covie154/smartknob/PCB_Scroller/Scroller1 two/Scroller1 two.pdf

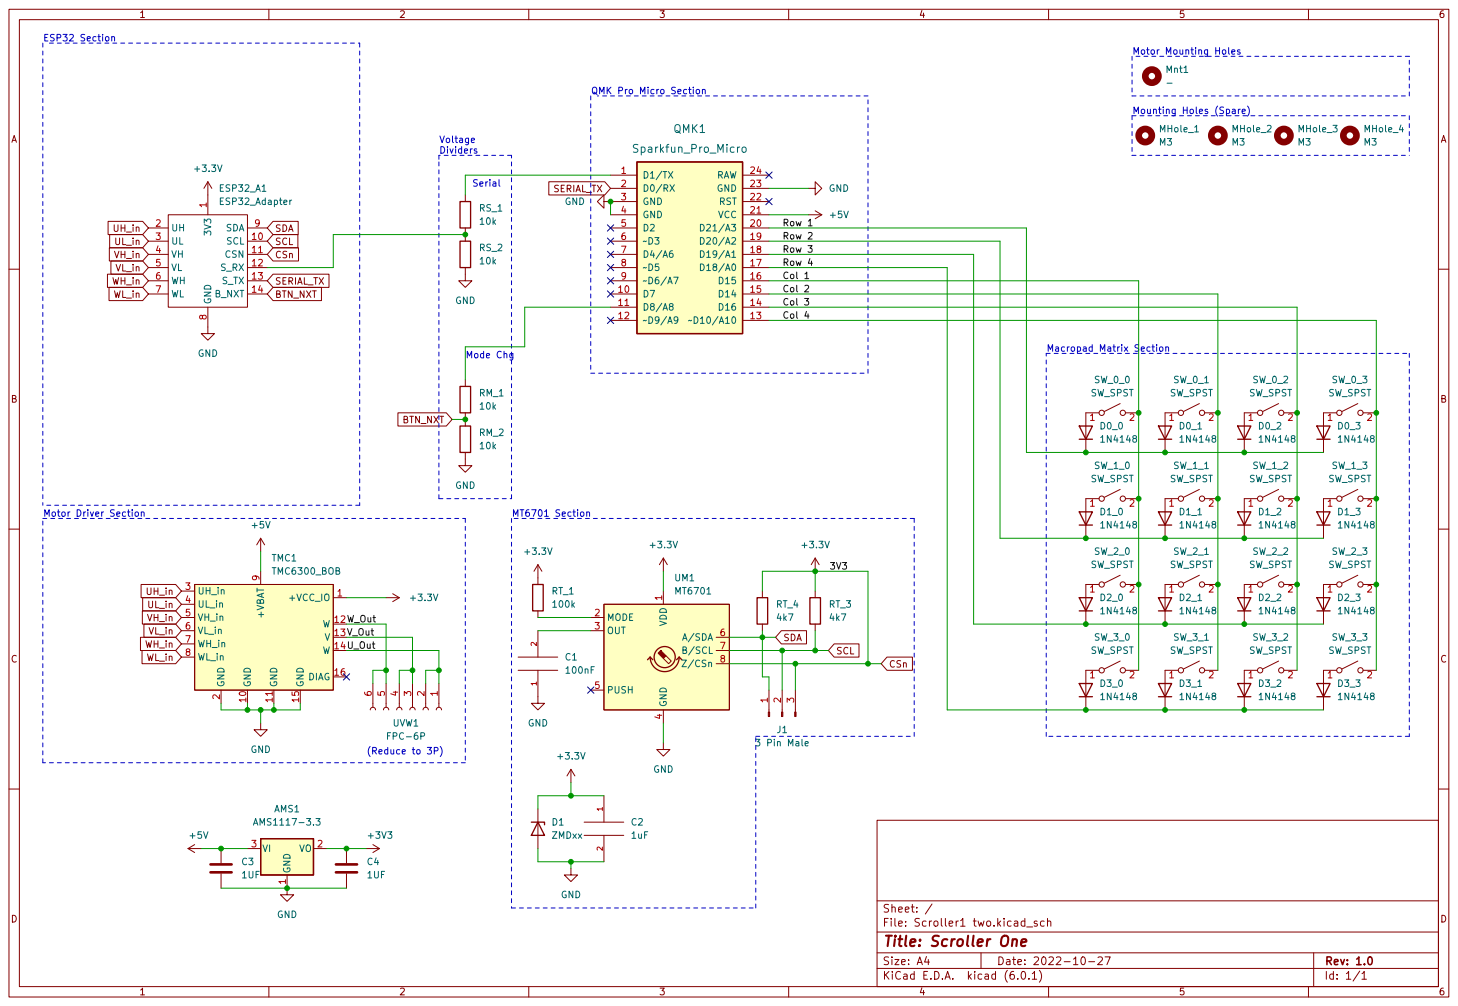
[picture p2: page 1]

Voltage Dividers Motor Driver Section

1 SCL 10 CSN 11 S_RX 12 S_TX 13 B_NXT 14 UH 2 UL 3 VH 4 VL 5 WH 6 WL 7 GND

1 2 SW_0_0 SW_SPST | 1 2 SW_0_1 SW_SPST D0_0 | 1 D0_2 2 SW_0_2 SW_SPST

1 2 SW_1_0 SW_SPST | 1 2 SW_1_1 SW_SPST 1 2 SW_2_1 SW_SPST D1_1

4 PUSH 5 A/SDA 6 B/SCL 7 Z/CSn 8 UM1 MT6701

Id: 1/1 Title: Scroller One
