covie154/smartknob/PCB_Scroller/Scroller1/Scroller1.pdf

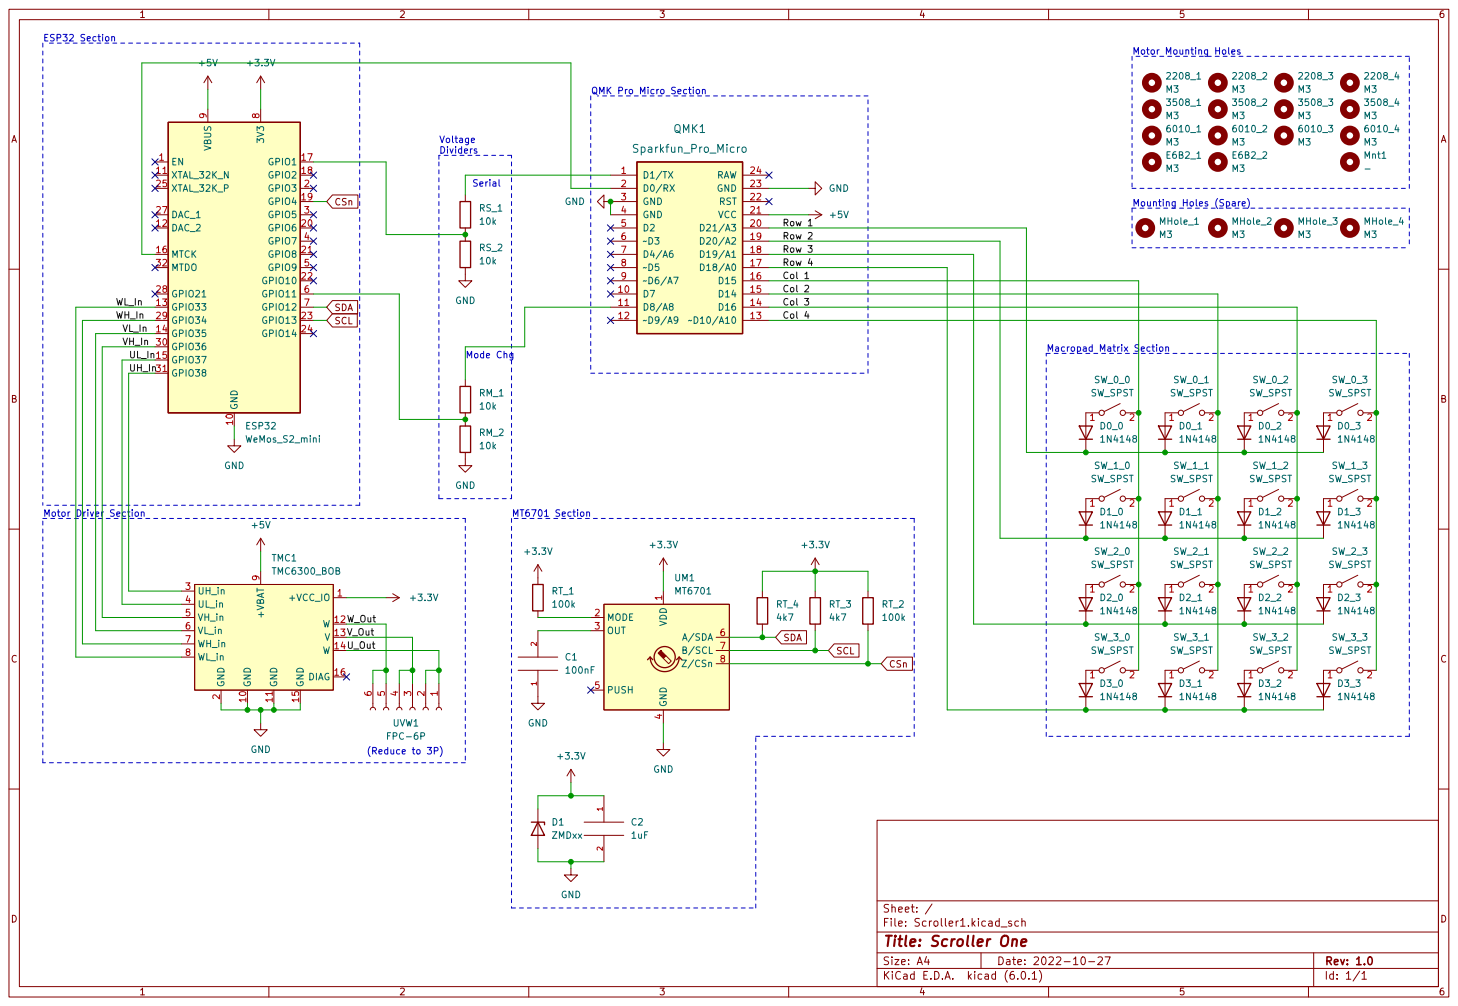
[picture p3: page 1]

Macropad Matrix Section Motor Driver Section

1 2 SW_1_1 SW_SPST 1 2 SW_2_1 SW_SPST D1_1 | 1 2 SW_1_2 SW_SPST

4 PUSH 5 A/SDA 6 B/SCL 7 Z/CSn 8 UM1 MT6701 GND

1 2 SW_2_0 SW_SPST

File: Scroller1.kicad_sch Sheet: /
Id: 1/1 Title: Scroller One
