covie154/smartknob/PCB_Scroller/ESP32_Adapter/ESP32_Adapter.kicad_pcb

## KiCad design PCB_Scroller/ESP32_Adapter/ESP32_Adapter.kicad_pcb (2023-05-04)

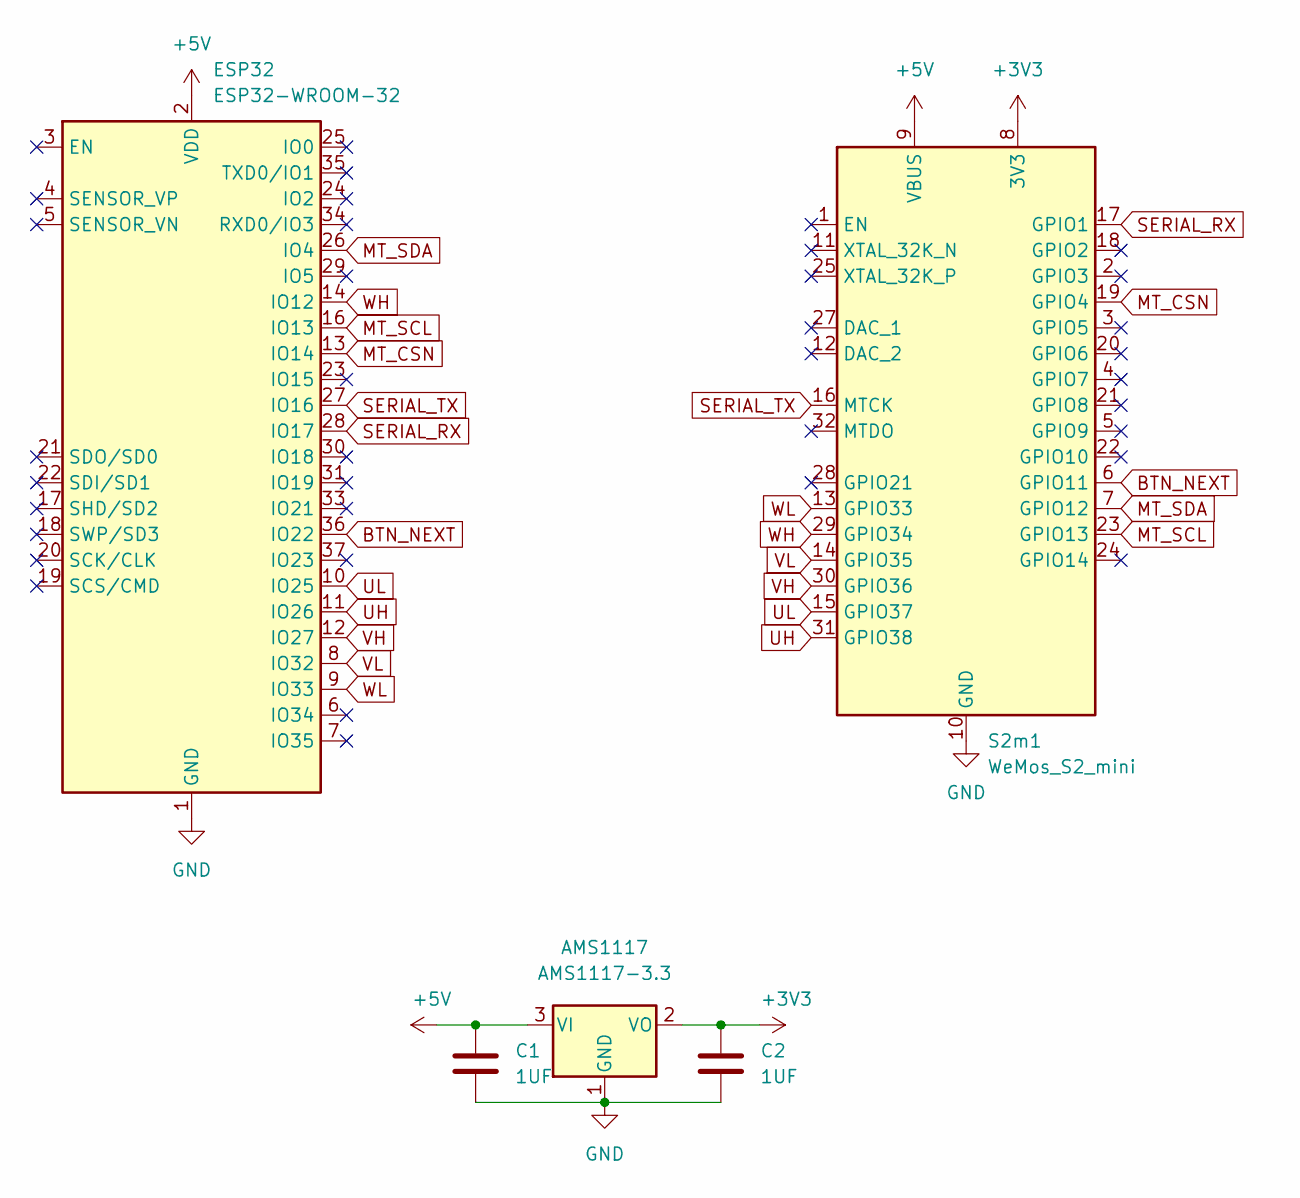
[picture p4: schematic ESP32_Adapter.kicad_sch]

Parts:
AMS1117: AMS1117-3.3; SOT-223-3_TabPin2
C1, C2: 1UF; C_0603_1608Metric_Pad1.08x0.95mm_HandSolder
ESP32: ESP32-WROOM-32
S2m1: WeMos_S2_mini; WEMOS_S2_mini

Connections:
+3V3: AMS1117.2 (VO), C2.1, S2m1.8 (3V3)
+5V: AMS1117.3 (VI), C1.1, ESP32.2 (VDD), S2m1.9 (VBUS)
BTN_NEXT: ESP32.36 (IO22), S2m1.6 (GPIO11)
GND: AMS1117.1 (GND), C1.2, C2.2, ESP32.1 (GND), ESP32.15 (GND), ESP32.38 (GND), ESP32.39 (GND), S2m1.10 (GND), S2m1.26 (GND)
MT_CSN: ESP32.13 (IO14), S2m1.19 (GPIO4)
MT_SCL: ESP32.16 (IO13), S2m1.23 (GPIO13)
MT_SDA: ESP32.26 (IO4), S2m1.7 (GPIO12)
SERIAL_RX: ESP32.28 (IO17), S2m1.17 (GPIO1)
SERIAL_TX: ESP32.27 (IO16), S2m1.16 (MTCK)
UH: ESP32.11 (IO26), S2m1.31 (GPIO38)
UL: ESP32.10 (IO25), S2m1.15 (GPIO37)
VH: ESP32.12 (IO27), S2m1.30 (GPIO36)
VL: ESP32.8 (IO32), S2m1.14 (GPIO35)
WH: ESP32.14 (IO12), S2m1.29 (GPIO34)
WL: ESP32.9 (IO33), S2m1.13 (GPIO33)

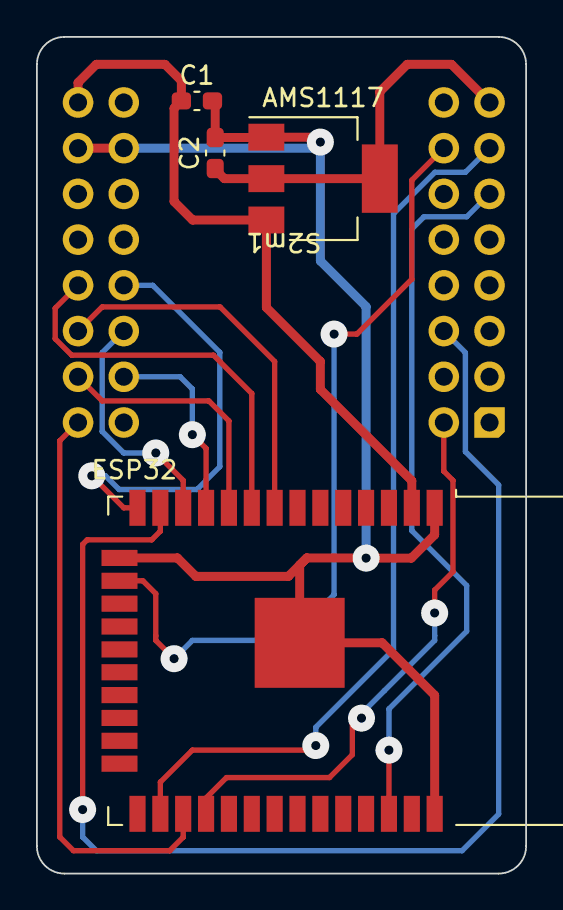
[picture p5: board ESP32_Adapter.kicad_pcb from above]

Board: 2 copper layers, 27.2 x 46.5 mm, 5 parts (0 on the bottom side), 15 nets.
