covie154/smartknob/PCB_Scroller/Scroller Motor 1/Scroller Motor 1.kicad_pcb

## KiCad design PCB_Scroller/Scroller Motor 1/Scroller Motor 1.kicad_pcb (2023-05-04)

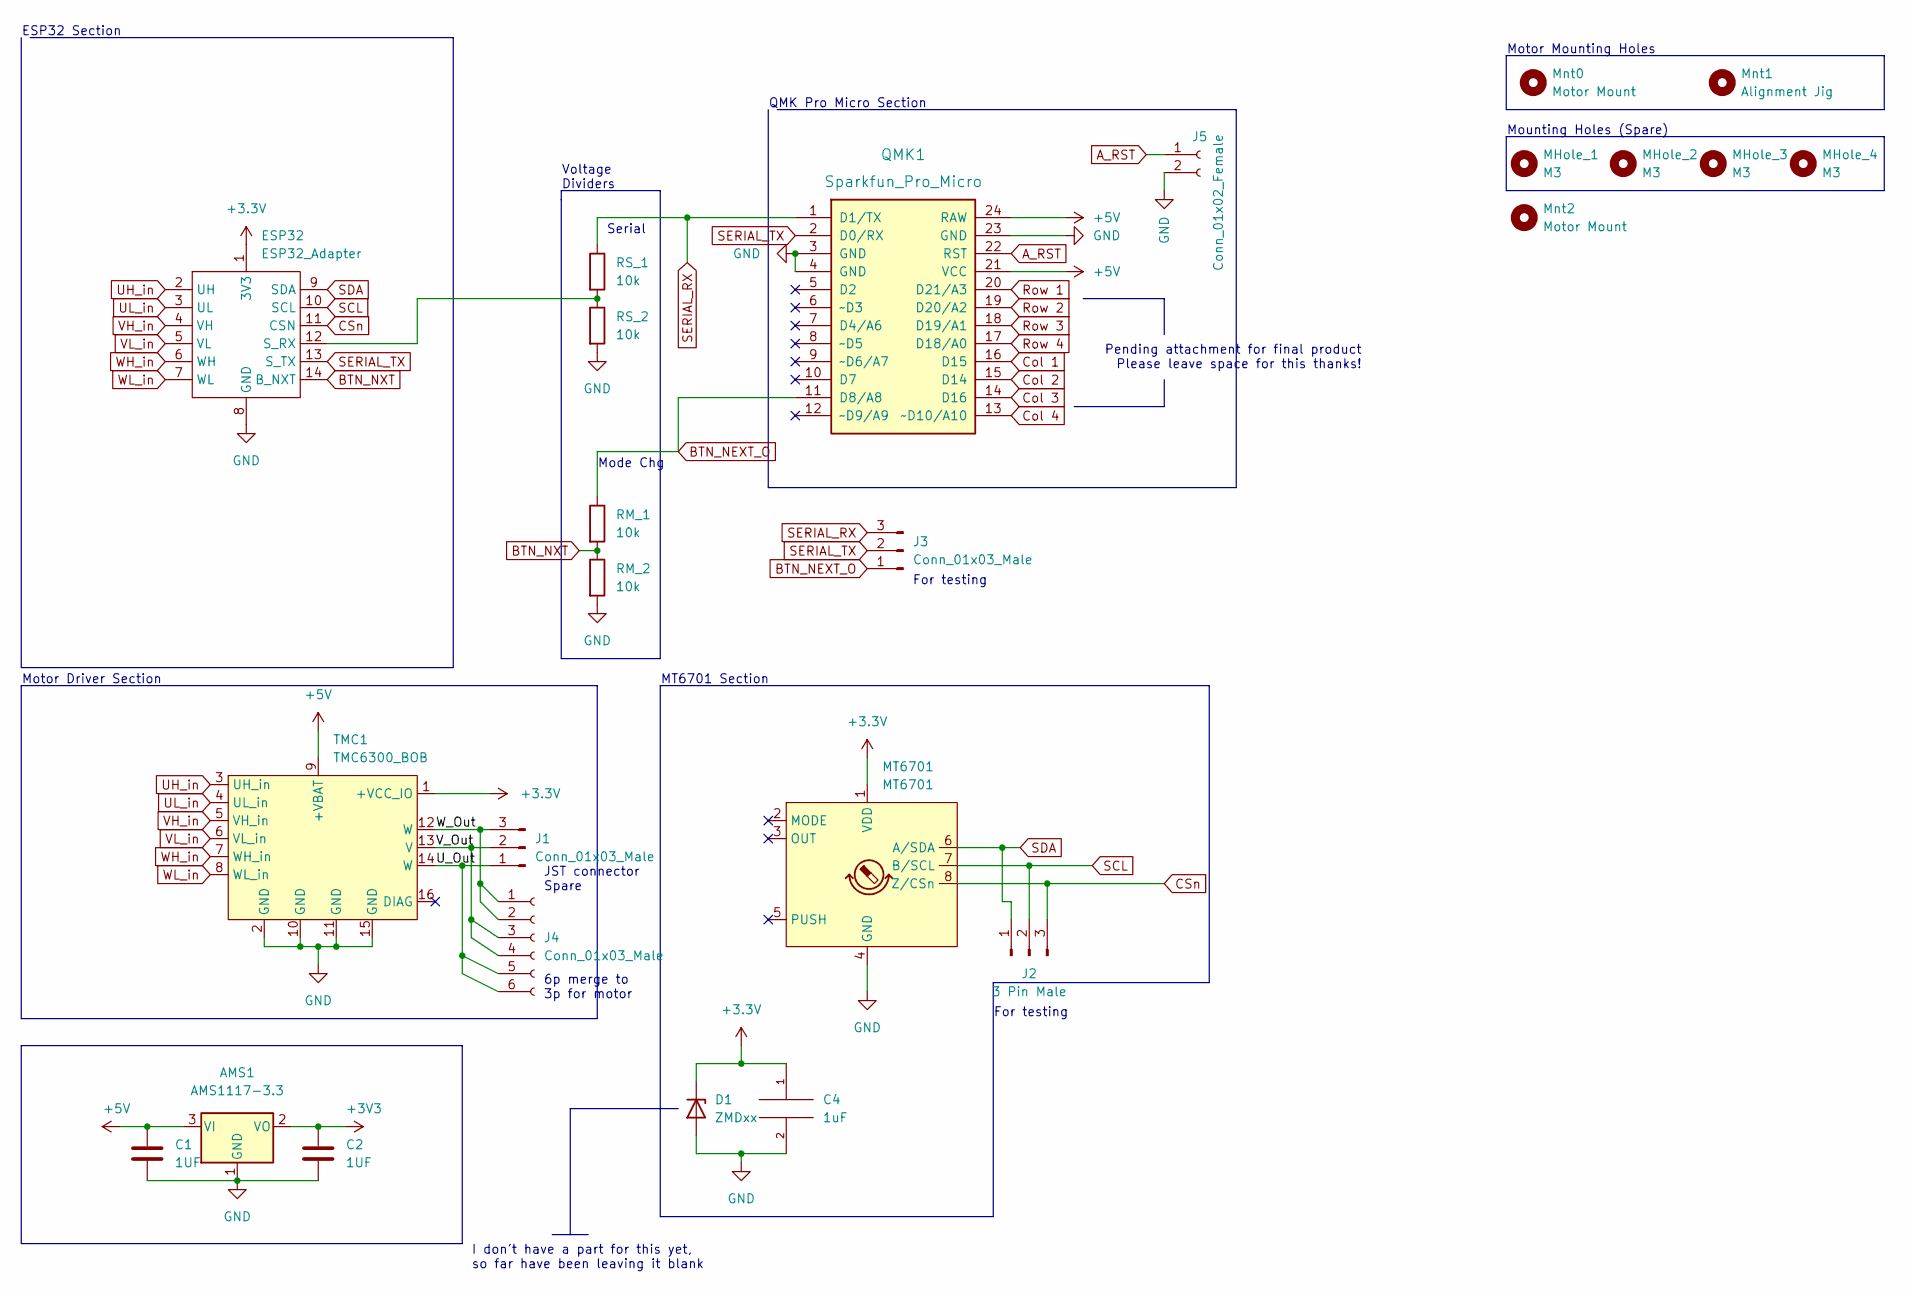
[picture p6: schematic Scroller Motor 1.kicad_sch]

Parts:
AMS1: AMS1117-3.3; SOT-223-3_TabPin2
C1, C2: 1UF; C_0603_1608Metric_Pad1.08x0.95mm_HandSolder
C4: 1uF; C_0603_1608Metric_Pad1.08x0.95mm_HandSolder
D1: ZMDxx; D_SOD-123
ESP32: ESP32_Adapter; ESP32 Motor Adapter
J1: Conn_01x03_Male; JST_XH_B3B-XH-AM_1x03_P2.50mm_Vertical
J2: 3 Pin Male; PinHeader_1x03_P2.54mm_Vertical
J3: Conn_01x03_Male; PinHeader_1x03_P2.54mm_Vertical
J4: Conn_01x03_Male; Hirose_FH12-6S-0.5SH_1x06-1MP_P0.50mm_Horizontal
J5: Conn_01x02_Female; PinHeader_1x02_P2.54mm_Vertical
MHole_1, MHole_2, MHole_3, MHole_4: M3; MountingHole_3.2mm_M3
MT6701: MT6701; SOIC-8
Mnt0: Motor Mount; BLDC Mount 3
Mnt1: Alignment Jig; Jig Mnt
Mnt2: Motor Mount; BLDC 3514
QMK1: Sparkfun_Pro_Micro
RM_1, RM_2: 10k; R_0603_1608Metric_Pad0.98x0.95mm_HandSolder
RS_1, RS_2: 10k; R_0603_1608Metric_Pad0.98x0.95mm_HandSolder
TMC1: TMC6300_BOB

Connections:
+5V: AMS1.3 (VI), C1.1, QMK1.21 (VCC), QMK1.24 (RAW), TMC1.9 (+VBAT)
/U_Out: J1.1, J4.5, J4.6, TMC1.14 (W)
/V_Out: J1.2, J4.3, J4.4, TMC1.13 (V)
/W_Out: J1.3, J4.1, J4.2, TMC1.12 (W)
A_RST: J5.1, QMK1.22 (RST)
BTN_NEXT_O: J3.1, QMK1.11 (D8/A8), RM_1.1
BTN_NXT: ESP32.14 (B_NXT), RM_1.2, RM_2.1
CSn: ESP32.11 (CSN), J2.3, MT6701.8 (Z/CSn)
Col 1: QMK1.16 (D15)
Col 2: QMK1.15 (D14)
Col 3: QMK1.14 (D16)
Col 4: QMK1.13 (~D10/A10)
GND: AMS1.1 (GND), C1.2, C2.2, C4.2, D1.2 (A), ESP32.8 (GND), J5.2, MT6701.4 (GND), QMK1.3 (GND), QMK1.4 (GND), QMK1.23 (GND), RM_2.2, RS_2.2, TMC1.2 (GND), TMC1.10 (GND), TMC1.11 (GND), TMC1.15 (GND)
unnamed: ESP32.12 (S_RX), RS_1.2, RS_2.1
Row 1: QMK1.20 (D21/A3)
Row 2: QMK1.19 (D20/A2)
Row 3: QMK1.18 (D19/A1)
Row 4: QMK1.17 (D18/A0)
SCL: ESP32.10 (SCL), J2.2, MT6701.7 (B/SCL)
SDA: ESP32.9 (SDA), J2.1, MT6701.6 (A/SDA)
SERIAL_RX: J3.3, QMK1.1 (D1/TX), RS_1.1
SERIAL_TX: ESP32.13 (S_TX), J3.2, QMK1.2 (D0/RX)
UH_in: ESP32.2 (UH), TMC1.3 (UH_in)
UL_in: ESP32.3 (UL), TMC1.4 (UL_in)
VH_in: ESP32.4 (VH), TMC1.5 (VH_in)
VL_in: ESP32.5 (VL), TMC1.6 (VL_in)
WH_in: ESP32.6 (WH), TMC1.7 (WH_in)
WL_in: ESP32.7 (WL), TMC1.8 (WL_in)

Notes on the sheet:
Mode Chg
For testing
Pending attachment for final product Please leave space for this thanks!
6p merge to 3p for motor
JST connector Spare
Motor Mounting Holes
Serial
ESP32 Section
Mounting Holes (Spare)
Voltage Dividers
MT6701 Section
I don't have a part for this yet, so far have been leaving it blank
QMK Pro Micro Section
Motor Driver Section

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
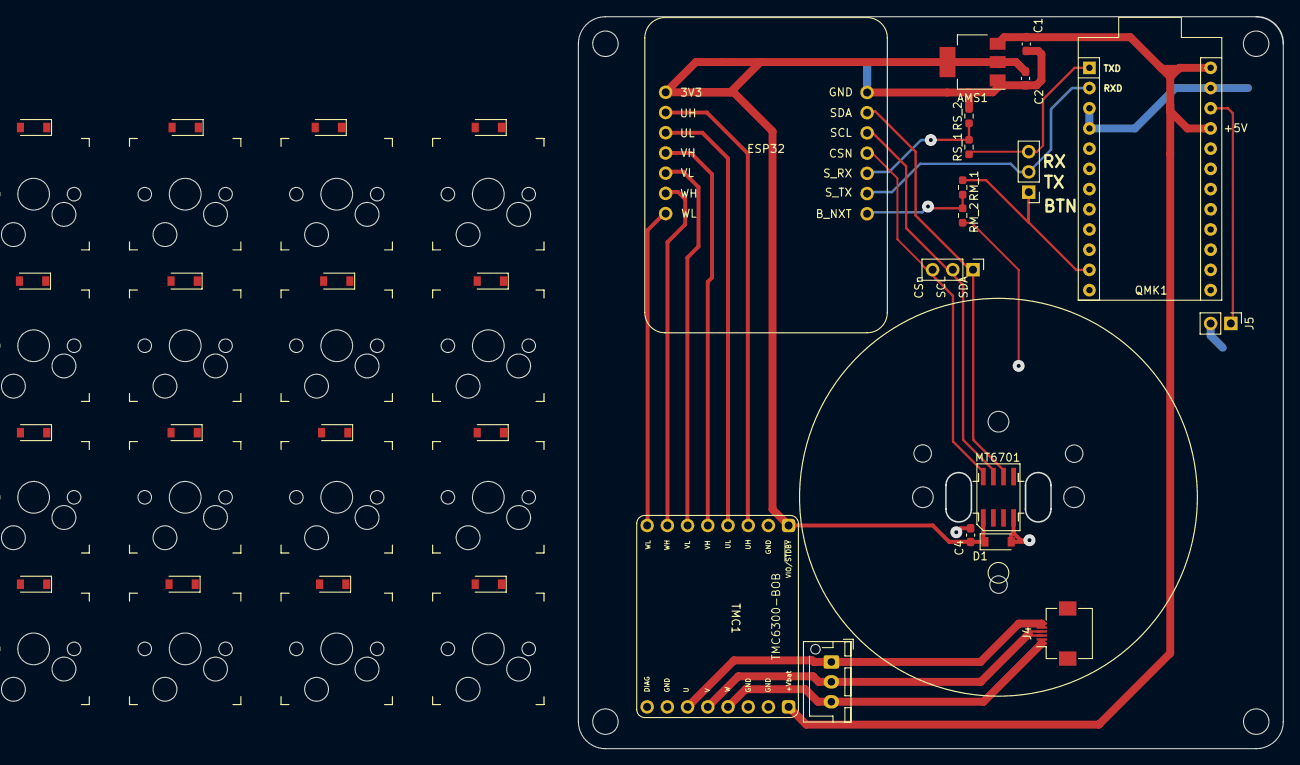
[picture p7: board Scroller Motor 1.kicad_pcb from above]

Board: 2 copper layers, 88.6 x 92.0 mm, 25 parts (0 on the bottom side), 21 nets.
