covie154/smartknob/PCB_Scroller/ESP32_Adapter 2/ESP32_Adapter 2.kicad_pcb

## KiCad design PCB_Scroller/ESP32_Adapter 2/ESP32_Adapter 2.kicad_pcb (2023-05-04)

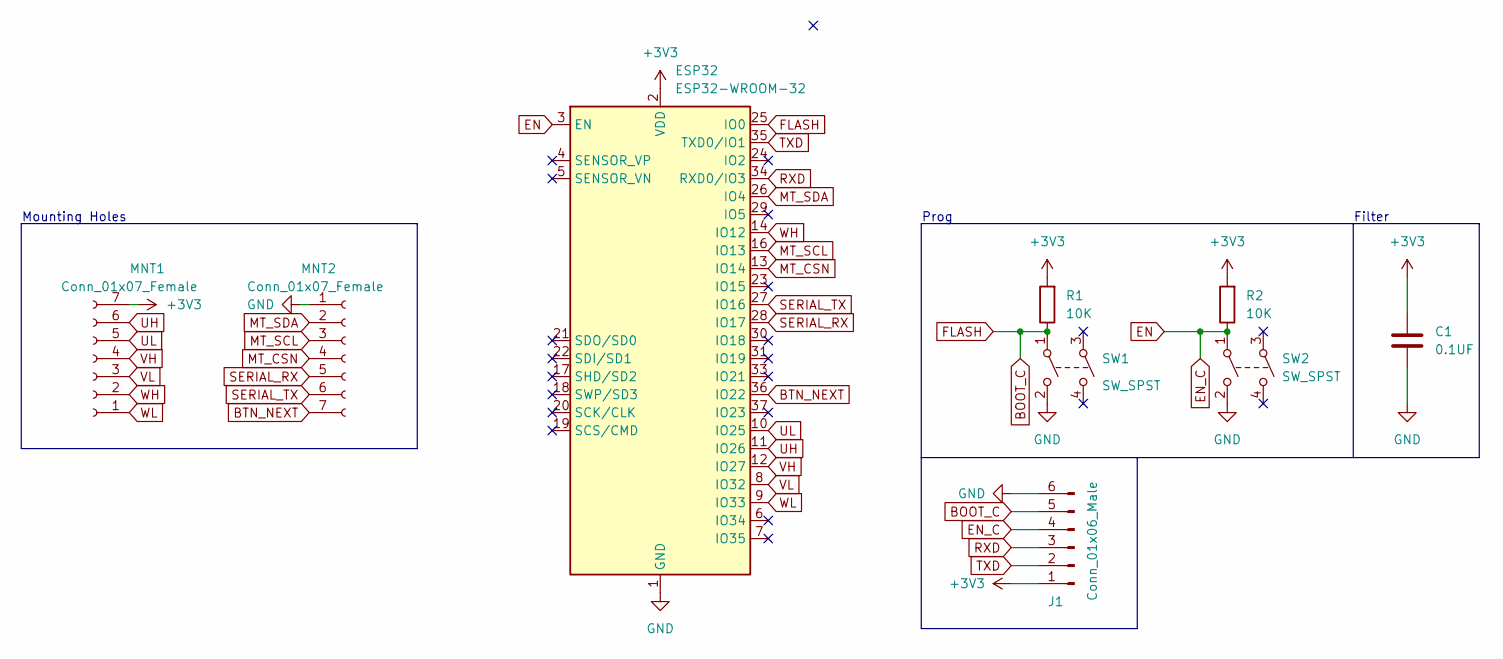
[picture p8: schematic ESP32_Adapter 2.kicad_sch]

Parts:
C1: 0.1UF; C_0603_1608Metric_Pad1.08x0.95mm_HandSolder
ESP32: ESP32-WROOM-32
J1: Conn_01x06_Male; PinHeader_1x07_P2.54mm_Horizontal
MNT1, MNT2: Conn_01x07_Female; PinSocket_1x07_P2.54mm_Vertical
R1, R2: 10K; R_0603_1608Metric_Pad0.98x0.95mm_HandSolder
SW1, SW2: SW_SPST; PTS525SM08SMTR2LFS

Connections:
+3V3: C1.1, ESP32.2 (VDD), J1.1, MNT1.7, R1.2, R2.2
BTN_NEXT: ESP32.36 (IO22), MNT2.7
EN: ESP32.3 (EN), J1.4, R2.1, SW2.1
FLASH: ESP32.25 (IO0), J1.5, R1.1, SW1.1
GND: C1.2, ESP32.1 (GND), ESP32.15 (GND), ESP32.38 (GND), ESP32.39 (GND), J1.6, MNT2.1, SW1.2, SW2.2
MT_CSN: ESP32.13 (IO14), MNT2.4
MT_SCL: ESP32.16 (IO13), MNT2.3
MT_SDA: ESP32.26 (IO4), MNT2.2
RXD: ESP32.34 (RXD0/IO3), J1.3
SERIAL_RX: ESP32.28 (IO17), MNT2.5
SERIAL_TX: ESP32.27 (IO16), MNT2.6
TXD: ESP32.35 (TXD0/IO1), J1.2
UH: ESP32.11 (IO26), MNT1.6
UL: ESP32.10 (IO25), MNT1.5
VH: ESP32.12 (IO27), MNT1.4
VL: ESP32.8 (IO32), MNT1.3
WH: ESP32.14 (IO12), MNT1.2
WL: ESP32.9 (IO33), MNT1.1

Notes on the sheet:
Mounting Holes
Filter
Prog

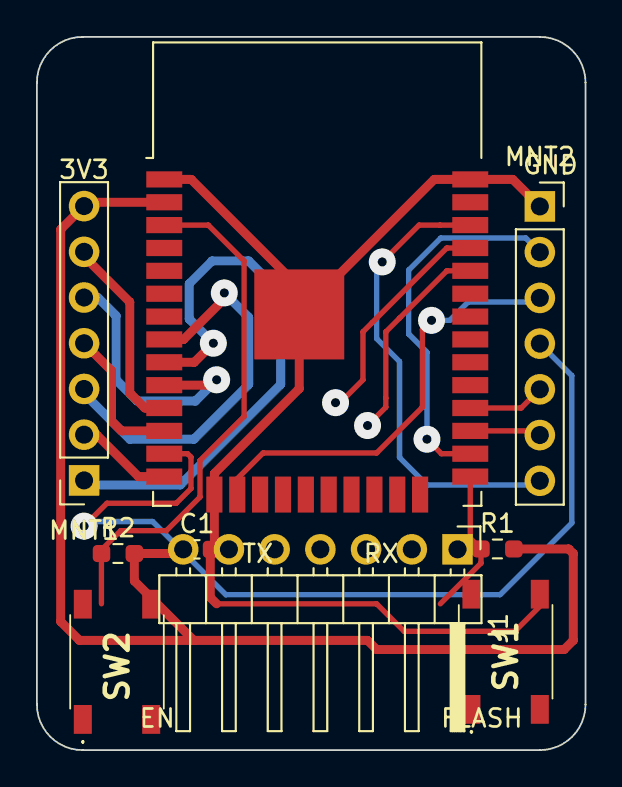
[picture p9: board ESP32_Adapter 2.kicad_pcb from above]

Board: 2 copper layers, 30.5 x 39.6 mm, 9 parts (0 on the bottom side), 18 nets.
