covie154/smartknob/PCB_Scroller/Scroller1 two/Scroller1 two.kicad_pcb

## KiCad design PCB_Scroller/Scroller1 two/Scroller1 two.kicad_pcb (2023-05-04)

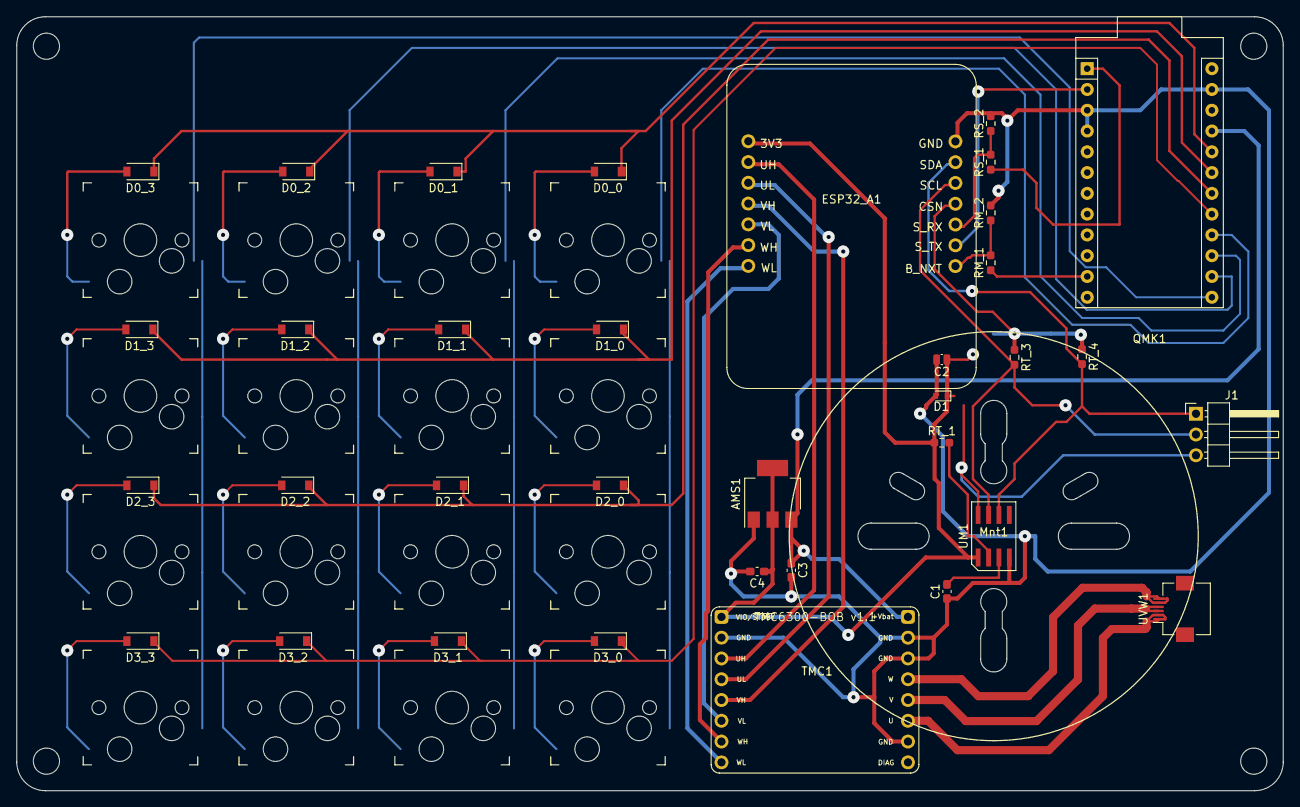
[picture p10: board Scroller1 two.kicad_pcb from above]

Board: 2 copper layers, 154.8 x 94.6 mm, 56 parts (0 on the bottom side), 44 nets.

Parts:
AMS1: AMS1117-3.3; SOT-223-3_TabPin2
C1: 100nF; C_0603_1608Metric_Pad1.08x0.95mm_HandSolder
C2: 1uF; C_0504_1310Metric_Pad0.83x1.28mm_HandSolder
C3, C4: 1UF; C_0603_1608Metric_Pad1.08x0.95mm_HandSolder
D0_0, D0_1, D0_2, D0_3, D1_0, D1_1, D1_2, D1_3, D2_0, D2_1, D2_2, D2_3, D3_0, D3_1, D3_2, D3_3: 1N4148; D_SOD-123
D1: ZMDxx; D_SOD-523
ESP32_A1: ESP32_Adapter; ESP32 Motor Adapter
J1: 3 Pin Male; PinHeader_1x03_P2.54mm_Horizontal
MHole_1, MHole_3, MHole_4, MHole_6: M3; MountingHole_3.2mm_M3
Mnt1: -; BLDC Mount
QMK1: Sparkfun_Pro_Micro
RM_1, RM_2: 10k; R_0603_1608Metric_Pad0.98x0.95mm_HandSolder
RS_1, RS_2: 10k; R_0603_1608Metric_Pad0.98x0.95mm_HandSolder
RT_1: 100k; R_0603_1608Metric_Pad0.98x0.95mm_HandSolder
RT_3, RT_4: 4k7; R_0603_1608Metric_Pad0.98x0.95mm_HandSolder
SW_0_0, SW_0_1, SW_0_2, SW_0_3, SW_1_0, SW_1_1, SW_1_2, SW_1_3, SW_2_0, SW_2_1, SW_2_2, SW_2_3, SW_3_0, SW_3_1, SW_3_2, SW_3_3: SW_SPST; Kailh_socket_MX
TMC1: TMC6300_BOB
UM1: MT6701; SOIC-8
UVW1: FPC-6P; Hirose_FH12-6S-0.5SH_1x06-1MP_P0.50mm_Horizontal

Connections:
+5V: AMS1.3 (VI), C3.1, QMK1.21 (VCC), TMC1.9 (+VBAT)
/Col 1: QMK1.16 (D15), SW_0_0.2 (B), SW_1_0.2 (B), SW_2_0.2 (B), SW_3_0.2 (B)
/Col 2: QMK1.15 (D14), SW_0_1.2 (B), SW_1_1.2 (B), SW_2_1.2 (B), SW_3_1.2 (B)
/Col 3: QMK1.14 (D16), SW_0_2.2 (B), SW_1_2.2 (B), SW_2_2.2 (B), SW_3_2.2 (B)
/Col 4: QMK1.13 (~D10/A10), SW_0_3.2 (B), SW_1_3.2 (B), SW_2_3.2 (B), SW_3_3.2 (B)
/Row 1: D0_0.1 (K), D0_1.1 (K), D0_2.1 (K), D0_3.1 (K), QMK1.20 (D21/A3)
/Row 2: D1_0.1 (K), D1_1.1 (K), D1_2.1 (K), D1_3.1 (K), QMK1.19 (D20/A2)
/Row 3: D2_0.1 (K), D2_1.1 (K), D2_2.1 (K), D2_3.1 (K), QMK1.18 (D19/A1)
/Row 4: D3_0.1 (K), D3_1.1 (K), D3_2.1 (K), D3_3.1 (K), QMK1.17 (D18/A0)
/U_Out: TMC1.14 (W), UVW1.1, UVW1.2
/V_Out: TMC1.13 (V), UVW1.3, UVW1.4
/W_Out: TMC1.12 (W), UVW1.5, UVW1.6
BTN_NXT: RM_1.2, RM_2.1
CSn: AMS1.2 (VO), C2.1, C4.1, D1.1 (K), ESP32_A1.1 (3V3), J1.3, RT_1.1, RT_3.1, RT_4.1, TMC1.1 (+VCC_IO), UM1.1 (VDD), UM1.8 (Z/CSn)
GND: AMS1.1 (GND), C1.1, C2.2, C3.2, C4.2, D1.2 (A), QMK1.3 (GND), QMK1.4 (GND), QMK1.23 (GND), RM_2.2, RS_2.2, TMC1.2 (GND), TMC1.10 (GND), TMC1.11 (GND), TMC1.15 (GND), UM1.4 (GND)
unnamed: C1.2, UM1.3 (OUT)
unnamed: D0_0.2 (A), SW_0_0.1 (A)
unnamed: D0_1.2 (A), SW_0_1.1 (A)
unnamed: D0_2.2 (A), SW_0_2.1 (A)
unnamed: D0_3.2 (A), SW_0_3.1 (A)
unnamed: D1_0.2 (A), SW_1_0.1 (A)
unnamed: D1_1.2 (A), SW_1_1.1 (A)
unnamed: D1_2.2 (A), SW_1_2.1 (A)
unnamed: D1_3.2 (A), SW_1_3.1 (A)
unnamed: D2_0.2 (A), SW_2_0.1 (A)
unnamed: D2_1.2 (A), SW_2_1.1 (A)
unnamed: D2_2.2 (A), SW_2_2.1 (A)
unnamed: D2_3.2 (A), SW_2_3.1 (A)
unnamed: D3_0.2 (A), SW_3_0.1 (A)
unnamed: D3_1.2 (A), SW_3_1.1 (A)
unnamed: D3_2.2 (A), SW_3_2.1 (A)
unnamed: D3_3.2 (A), SW_3_3.1 (A)
unnamed: RS_1.2, RS_2.1
unnamed: QMK1.1 (D1/TX), RS_1.1
unnamed: QMK1.11 (D8/A8), RM_1.1
unnamed: RT_1.2, UM1.2 (MODE)
SCL: J1.2, RT_3.2, UM1.7 (B/SCL)
SDA: J1.1, RT_4.2, UM1.6 (A/SDA)
UH_in: ESP32_A1.2 (UH), TMC1.3 (UH_in)
UL_in: ESP32_A1.3 (UL), TMC1.4 (UL_in)
VH_in: ESP32_A1.4 (VH), TMC1.5 (VH_in)
VL_in: ESP32_A1.5 (VL), TMC1.6 (VL_in)
WH_in: ESP32_A1.6 (WH), TMC1.7 (WH_in)
WL_in: ESP32_A1.7 (WL), TMC1.8 (WL_in)
