covie154/smartknob/PCB_Scroller/TMC6300-BOB/TMC6300-BOB Component.kicad_pcb

## KiCad design PCB_Scroller/TMC6300-BOB/TMC6300-BOB Component.kicad_pcb (2022-11-05)

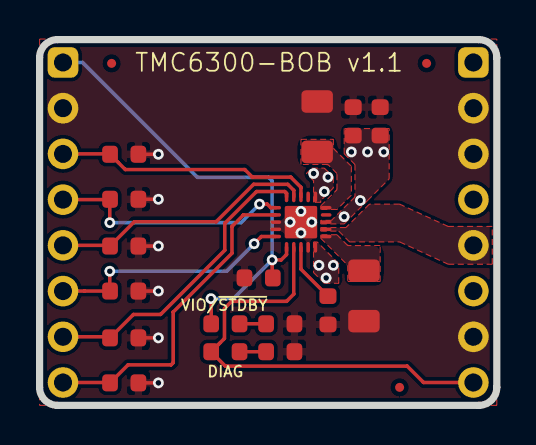
[picture p11: board TMC6300-BOB Component.kicad_pcb from above]

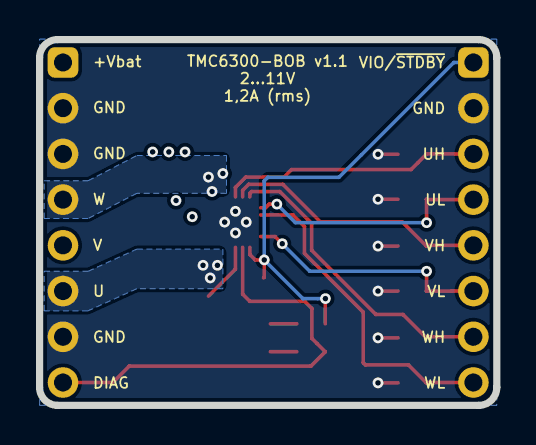
[picture p12: board TMC6300-BOB Component.kicad_pcb from below]

Board: 4 copper layers, 25.4 x 20.3 mm, 22 parts (2 on the bottom side), 18 nets.

Parts:
C101: 10μF/25V/0603; C_0603_1608Metric
C102, C104: 100nF/25V/0603; C_0603_1608Metric
C105: 100nF/10V/0603; C_0603_1608Metric
D101: White; LED_0603_1608Metric
D102: Blue; LED_0603_1608Metric
IC101: TMC6300; QFN20
J101, J102: Conn_01x08_Male; PinHeader_1x08_P2.54mm_Vertical
R101, R102, R103, R104, R105, R106: 100kΩ/1%/0603; R_0603_1608Metric
R107: 220Ω/1%/0603; R_0603_1608Metric
R108: 1kΩ/1%/0603; R_0603_1608Metric
R109, R110: 150mΩ/0,5W; R_1206_3216Metric
fid101, fid102, fid103: fiducial; Fiducial_0.5mm_Dia_1mm_Outer

Connections:
/+Vbat: C101.1, C102.1, IC101.18, J102.1
/DIAG: D101.2, IC101.12, J102.8
/U: IC101.15, J102.6
/UH: IC101.3, J101.3, R101.2
/UL: IC101.6, J101.4, R102.1
/V: IC101.17, J102.5
/VH: IC101.4, J101.5, R103.1
/VIO\~STDBY: C104.1, D102.2, IC101.11, J101.1
/VL: IC101.10, J101.6, R104.1
/W: IC101.1, J102.4
/WH: IC101.5, J101.7, R105.1
/WL: IC101.7, J101.8, R106.1
GND: C101.2, C102.2, C104.2, C105.2, IC101.8, IC101.9, IC101.14, IC101.PAD, J101.2, J102.2, J102.3, J102.7, R101.1, R102.2, R103.2, R104.2, R105.2, R106.2, R107.2, R108.2, R109.2, R110.2
unnamed: C105.1, IC101.13
unnamed: D101.1, R107.1
unnamed: D102.1, R108.1
unnamed: IC101.16, R110.1
unnamed: IC101.20, R109.1
