covie154/smartknob/firmware/src/motor_task.h

#pragma once

#include <Arduino.h>
#include <vector>

#include "knob_data.h"
#include "task.h"


enum class CommandType {
    CONFIG,
    HAPTIC,
};

struct HapticData {
    bool press;
};

struct Command {
    CommandType command_type;
    union CommandData {
        KnobConfig config;
        HapticData haptic;
    };
    CommandData data;
};

class MotorTask : public Task<MotorTask> {
    friend class Task<MotorTask>; // Allow base Task to invoke protected run()

    public:
        MotorTask(const uint8_t task_core);
        ~MotorTask();

        void setConfig(const KnobConfig& config);
        void playHaptic(bool press);

        void addListener(QueueHandle_t queue);

        float angle();

    protected:
        void run();

    private:
        QueueHandle_t queue_;

        std::vector<QueueHandle_t> listeners_;

        void publish(const KnobState& state);
};
