covie154/smartknob/(commit log)

2022-11-05 Version 1
    [Scroller1.kicad_pcb, Scroller1.kicad_sch, TMC6300-BOB Component.kicad_pcb, TMC6300-BOB v1.1.kicad_pcb, TMC6300-BOB v1.1.kicad_sch, TMC6300-BOB v1.1.sch]
2022-11-08 Updates
    Not sure if the ESP32 works...
    [Scroller1-B_Cu.gbr, Scroller1-B_Mask.gbr, Scroller1-B_Paste.gbr, Scroller1-B_Silkscreen.gbr, Scroller1-Edge_Cuts.gbr, Scroller1-F_Cu.gbr, Scroller1-F_Mask.gbr, Scroller1-F_Paste.gbr]
2023-05-04 Update 040523
    Changed lots of things
    [ESP32_Adapter 2-B_Cu.gbr, ESP32_Adapter 2-B_Mask.gbr, ESP32_Adapter 2-B_Paste.gbr, ESP32_Adapter 2-B_Silkscreen.gbr, ESP32_Adapter 2-Edge_Cuts.gbr, ESP32_Adapter 2-F_Cu.gbr, ESP32_Adapter 2-F_Mask.gbr, ESP32_Adapter 2-F_Paste.gbr]
